1789652968/tele9782-dband-patch/02_Simulation_Results/Farfield_150_CST.png

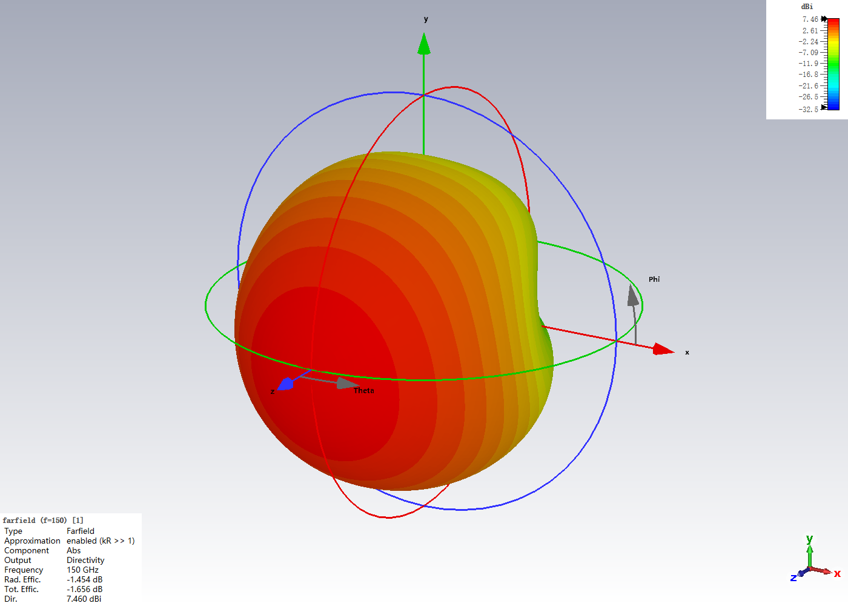
02_Simulation_Results/Farfield_150_CST.png
