1789652968/tele9782-dband-patch/01_CST_Project/farfield_146_summary.txt

Farfield Summary
---------------------
Array pattern: Single antenna
Monitor name: farfield (f=146) [1]
Plot mode: Directivity
Component: Abs
Plot type: 2D
Step angle Theta: 2
Step angle Phi  : 2
Coordinates: Spherical
Polarization: Abs
Frequency : 146 GHz
Radiation efficiency: -1.50464 dB 
Total efficiency: -2.62617 dB
Maximum directivity [dB]: 7.20686
Maximum gain [dB]: 5.70221
Maximum realized gain [dB]: 4.58069
