1789652968/tele9782-dband-patch/01_CST_Project/farfield_147_summary.txt

Farfield Summary
---------------------
Array pattern: Single antenna
Monitor name: farfield (f=147) [1]
Plot mode: Directivity
Component: Abs
Plot type: 2D
Step angle Theta: 2
Step angle Phi  : 2
Coordinates: Spherical
Polarization: Abs
Frequency : 147 GHz
Radiation efficiency: -1.44392 dB 
Total efficiency: -1.95549 dB
Maximum directivity [dB]: 7.28347
Maximum gain [dB]: 5.83955
Maximum realized gain [dB]: 5.32798
