1789652968/tele9782-dband-patch/01_CST_Project/farfield_149_summary.txt

Farfield Summary
---------------------
Array pattern: Single antenna
Monitor name: farfield (f=149) [1]
Plot mode: Directivity
Component: Abs
Plot type: 2D
Step angle Theta: 2
Step angle Phi  : 2
Coordinates: Spherical
Polarization: Abs
Frequency : 149 GHz
Radiation efficiency: -1.4239 dB 
Total efficiency: -1.42811 dB
Maximum directivity [dB]: 7.40966
Maximum gain [dB]: 5.98575
Maximum realized gain [dB]: 5.98155
