1789652968/tele9782-dband-patch/01_CST_Project/farfield_150_summary.txt

Farfield Summary
---------------------
Array pattern: Single antenna
Monitor name: farfield (f=150) [1]
Plot mode: Directivity
Component: Abs
Plot type: 2D
Step angle Theta: 2
Step angle Phi  : 2
Coordinates: Spherical
Polarization: Abs
Frequency : 150 GHz
Radiation efficiency: -1.45371 dB 
Total efficiency: -1.65573 dB
Maximum directivity [dB]: 7.46017
Maximum gain [dB]: 6.00646
Maximum realized gain [dB]: 5.80443
