1789652968/tele9782-dband-patch/01_CST_Project/farfield_152_summary.txt

Farfield Summary
---------------------
Array pattern: Single antenna
Monitor name: farfield (f=152) [1]
Plot mode: Directivity
Component: Abs
Plot type: 2D
Step angle Theta: 2
Step angle Phi  : 2
Coordinates: Spherical
Polarization: Abs
Frequency : 152 GHz
Radiation efficiency: -1.6087 dB 
Total efficiency: -2.87461 dB
Maximum directivity [dB]: 7.53211
Maximum gain [dB]: 5.92341
Maximum realized gain [dB]: 4.65751
