1789652968/tele9782-dband-patch/06_Working/Box_Coarse/farfield_130_summary.txt

Farfield Summary
---------------------
Array pattern: Single antenna
Monitor name: farfield (f=130) [1]
Plot mode: Directivity
Component: Abs
Plot type: 2D
Step angle Theta: 2
Step angle Phi  : 2
Coordinates: Spherical
Polarization: Abs
Frequency : 130 GHz
Radiation efficiency: -3.75192 dB 
Total efficiency: -12.4279 dB
Maximum directivity [dB]: 4.8401
Maximum gain [dB]: 1.08818
Maximum realized gain [dB]: -7.58782
