1789652968/tele9782-dband-patch/06_Working/Box_Coarse/farfield_140_summary.txt

Farfield Summary
---------------------
Array pattern: Single antenna
Monitor name: farfield (f=140) [1]
Plot mode: Directivity
Component: Abs
Plot type: 2D
Step angle Theta: 2
Step angle Phi  : 2
Coordinates: Spherical
Polarization: Abs
Frequency : 140 GHz
Radiation efficiency: -2.28199 dB 
Total efficiency: -7.97119 dB
Maximum directivity [dB]: 6.37631
Maximum gain [dB]: 4.09433
Maximum realized gain [dB]: -1.59488
