1789652968/tele9782-dband-patch/06_Working/Box_Coarse/farfield_148_summary.txt

Farfield Summary
---------------------
Array pattern: Single antenna
Monitor name: farfield (f=148) [1]
Plot mode: Directivity
Component: Abs
Plot type: 2D
Step angle Theta: 2
Step angle Phi  : 2
Coordinates: Spherical
Polarization: Abs
Frequency : 148 GHz
Radiation efficiency: -1.34051 dB 
Total efficiency: -1.76853 dB
Maximum directivity [dB]: 7.35717
Maximum gain [dB]: 6.01666
Maximum realized gain [dB]: 5.58864
