1789652968/tele9782-dband-patch/06_Working/Box_Coarse/farfield_149_summary.txt

Farfield Summary
---------------------
Array pattern: Single antenna
Monitor name: farfield (f=149) [1]
Plot mode: Directivity
Component: Abs
Plot type: 2D
Step angle Theta: 2
Step angle Phi  : 2
Coordinates: Spherical
Polarization: Abs
Frequency : 149 GHz
Radiation efficiency: -1.32675 dB 
Total efficiency: -1.39835 dB
Maximum directivity [dB]: 7.43263
Maximum gain [dB]: 6.10588
Maximum realized gain [dB]: 6.03429
