1789652968/tele9782-dband-patch/06_Working/Box_Coarse/farfield_150_summary.txt

Farfield Summary
---------------------
Array pattern: Single antenna
Monitor name: farfield (f=150) [1]
Plot mode: Directivity
Component: Abs
Plot type: 2D
Step angle Theta: 2
Step angle Phi  : 2
Coordinates: Spherical
Polarization: Abs
Frequency : 150 GHz
Radiation efficiency: -1.33562 dB 
Total efficiency: -1.35309 dB
Maximum directivity [dB]: 7.49745
Maximum gain [dB]: 6.16183
Maximum realized gain [dB]: 6.14435
