1789652968/tele9782-dband-patch/06_Working/Box_Coarse/farfield_151_summary.txt

Farfield Summary
---------------------
Array pattern: Single antenna
Monitor name: farfield (f=151) [1]
Plot mode: Directivity
Component: Abs
Plot type: 2D
Step angle Theta: 2
Step angle Phi  : 2
Coordinates: Spherical
Polarization: Abs
Frequency : 151 GHz
Radiation efficiency: -1.36631 dB 
Total efficiency: -1.63684 dB
Maximum directivity [dB]: 7.55461
Maximum gain [dB]: 6.1883
Maximum realized gain [dB]: 5.91777
