1789652968/tele9782-dband-patch/06_Working/Box_Coarse/farfield_153_summary.txt

Farfield Summary
---------------------
Array pattern: Single antenna
Monitor name: farfield (f=153) [1]
Plot mode: Directivity
Component: Abs
Plot type: 2D
Step angle Theta: 2
Step angle Phi  : 2
Coordinates: Spherical
Polarization: Abs
Frequency : 153 GHz
Radiation efficiency: -1.51605 dB 
Total efficiency: -2.92833 dB
Maximum directivity [dB]: 7.63794
Maximum gain [dB]: 6.12189
Maximum realized gain [dB]: 4.70961
