1789652968/tele9782-dband-patch/06_Working/Box_Coarse/farfield_154_summary.txt

Farfield Summary
---------------------
Array pattern: Single antenna
Monitor name: farfield (f=154) [1]
Plot mode: Directivity
Component: Abs
Plot type: 2D
Step angle Theta: 2
Step angle Phi  : 2
Coordinates: Spherical
Polarization: Abs
Frequency : 154 GHz
Radiation efficiency: -1.62988 dB 
Total efficiency: -3.73695 dB
Maximum directivity [dB]: 7.66373
Maximum gain [dB]: 6.03386
Maximum realized gain [dB]: 3.92678
