1789652968/tele9782-dband-patch/06_Working/Box_Coarse/farfield_160_summary.txt

Farfield Summary
---------------------
Array pattern: Single antenna
Monitor name: farfield (f=160) [1]
Plot mode: Directivity
Component: Abs
Plot type: 2D
Step angle Theta: 2
Step angle Phi  : 2
Coordinates: Spherical
Polarization: Abs
Frequency : 160 GHz
Radiation efficiency: -2.5683 dB 
Total efficiency: -8.09701 dB
Maximum directivity [dB]: 7.62737
Maximum gain [dB]: 5.05907
Maximum realized gain [dB]: -0.469641
