1789652968/tele9782-dband-patch/06_Working/Box_Coarse/farfield_170_summary.txt

Farfield Summary
---------------------
Array pattern: Single antenna
Monitor name: farfield (f=170) [1]
Plot mode: Directivity
Component: Abs
Plot type: 2D
Step angle Theta: 2
Step angle Phi  : 2
Coordinates: Spherical
Polarization: Abs
Frequency : 170 GHz
Radiation efficiency: -4.07395 dB 
Total efficiency: -11.7199 dB
Maximum directivity [dB]: 7.00213
Maximum gain [dB]: 2.92817
Maximum realized gain [dB]: -4.71778
