1789652968/tele9782-dband-patch/06_Working/Box_Fine/farfield_170_summary.txt

Farfield Summary
---------------------
Array pattern: Single antenna
Monitor name: farfield (f=170) [1]
Plot mode: Directivity
Component: Abs
Plot type: 2D
Step angle Theta: 2
Step angle Phi  : 2
Coordinates: Spherical
Polarization: Abs
Frequency : 170 GHz
Radiation efficiency: -4.36843 dB 
Total efficiency: -11.6953 dB
Maximum directivity [dB]: 6.99306
Maximum gain [dB]: 2.62463
Maximum realized gain [dB]: -4.70224
