1789652968/tele9782-dband-patch/06_Working/Inset_0.13/farfield_170_summary.txt

Farfield Summary
---------------------
Array pattern: Single antenna
Monitor name: farfield (f=170) [1]
Plot mode: Directivity
Component: Abs
Plot type: 2D
Step angle Theta: 2
Step angle Phi  : 2
Coordinates: Spherical
Polarization: Abs
Frequency : 170 GHz
Radiation efficiency: -3.3543 dB 
Total efficiency: -10.0292 dB
Maximum directivity [dB]: 7.95644
Maximum gain [dB]: 4.60214
Maximum realized gain [dB]: -2.07281
