1789652968/tele9782-dband-patch/06_Working/Inset_0.17/farfield_150_summary.txt

Farfield Summary
---------------------
Array pattern: Single antenna
Monitor name: farfield (f=150) [1]
Plot mode: Directivity
Component: Abs
Plot type: 2D
Step angle Theta: 2
Step angle Phi  : 2
Coordinates: Spherical
Polarization: Abs
Frequency : 150 GHz
Radiation efficiency: -1.55183 dB 
Total efficiency: -2.03358 dB
Maximum directivity [dB]: 7.71211
Maximum gain [dB]: 6.16028
Maximum realized gain [dB]: 5.67853
