1789652968/tele9782-dband-patch/06_Working/Inset_0.17/farfield_160_summary.txt

Farfield Summary
---------------------
Array pattern: Single antenna
Monitor name: farfield (f=160) [1]
Plot mode: Directivity
Component: Abs
Plot type: 2D
Step angle Theta: 2
Step angle Phi  : 2
Coordinates: Spherical
Polarization: Abs
Frequency : 160 GHz
Radiation efficiency: -2.66862 dB 
Total efficiency: -7.95058 dB
Maximum directivity [dB]: 7.91719
Maximum gain [dB]: 5.24857
Maximum realized gain [dB]: -0.0333876
