1789652968/tele9782-dband-patch/06_Working/Inset_0.19/farfield_130_summary.txt

Farfield Summary
---------------------
Array pattern: Single antenna
Monitor name: farfield (f=130) [1]
Plot mode: Directivity
Component: Abs
Plot type: 2D
Step angle Theta: 2
Step angle Phi  : 2
Coordinates: Spherical
Polarization: Abs
Frequency : 130 GHz
Radiation efficiency: -3.77351 dB 
Total efficiency: -12.2152 dB
Maximum directivity [dB]: 5.5448
Maximum gain [dB]: 1.77129
Maximum realized gain [dB]: -6.67037
