1789652968/tele9782-dband-patch/06_Working/Inset_0.19/farfield_140_summary.txt

Farfield Summary
---------------------
Array pattern: Single antenna
Monitor name: farfield (f=140) [1]
Plot mode: Directivity
Component: Abs
Plot type: 2D
Step angle Theta: 2
Step angle Phi  : 2
Coordinates: Spherical
Polarization: Abs
Frequency : 140 GHz
Radiation efficiency: -2.14669 dB 
Total efficiency: -6.7448 dB
Maximum directivity [dB]: 6.82934
Maximum gain [dB]: 4.68265
Maximum realized gain [dB]: 0.0845459
