1789652968/tele9782-dband-patch/06_Working/Inset_0.19/farfield_170_summary.txt

Farfield Summary
---------------------
Array pattern: Single antenna
Monitor name: farfield (f=170) [1]
Plot mode: Directivity
Component: Abs
Plot type: 2D
Step angle Theta: 2
Step angle Phi  : 2
Coordinates: Spherical
Polarization: Abs
Frequency : 170 GHz
Radiation efficiency: -4.38659 dB 
Total efficiency: -12.2489 dB
Maximum directivity [dB]: 7.15376
Maximum gain [dB]: 2.76717
Maximum realized gain [dB]: -5.09515
