1789652968/tele9782-dband-patch/06_Working/Single_Baseline/farfield_140_summary.txt

Farfield Summary
---------------------
Array pattern: Single antenna
Monitor name: farfield (f=140) [1]
Plot mode: Directivity
Component: Abs
Plot type: 2D
Step angle Theta: 2
Step angle Phi  : 2
Coordinates: Spherical
Polarization: Abs
Frequency : 140 GHz
Radiation efficiency: -2.01016 dB 
Total efficiency: -5.92421 dB
Maximum directivity [dB]: 6.83598
Maximum gain [dB]: 4.82582
Maximum realized gain [dB]: 0.911762
