1789652968/tele9782-dband-patch/06_Working/Single_Baseline/farfield_160_summary.txt

Farfield Summary
---------------------
Array pattern: Single antenna
Monitor name: farfield (f=160) [1]
Plot mode: Directivity
Component: Abs
Plot type: 2D
Step angle Theta: 2
Step angle Phi  : 2
Coordinates: Spherical
Polarization: Abs
Frequency : 160 GHz
Radiation efficiency: -2.36854 dB 
Total efficiency: -7.09138 dB
Maximum directivity [dB]: 8.05388
Maximum gain [dB]: 5.68534
Maximum realized gain [dB]: 0.962498
