1789652968/tele9782-dband-patch/06_Working/Single_Baseline/farfield_170_summary.txt

Farfield Summary
---------------------
Array pattern: Single antenna
Monitor name: farfield (f=170) [1]
Plot mode: Directivity
Component: Abs
Plot type: 2D
Step angle Theta: 2
Step angle Phi  : 2
Coordinates: Spherical
Polarization: Abs
Frequency : 170 GHz
Radiation efficiency: -3.47748 dB 
Total efficiency: -10.413 dB
Maximum directivity [dB]: 7.67602
Maximum gain [dB]: 4.19855
Maximum realized gain [dB]: -2.73693
