1789652968/tele9782-dband-patch/06_Working/Tuned_Coarse/farfield_130_summary.txt

Farfield Summary
---------------------
Array pattern: Single antenna
Monitor name: farfield (f=130) [1]
Plot mode: Directivity
Component: Abs
Plot type: 2D
Step angle Theta: 2
Step angle Phi  : 2
Coordinates: Spherical
Polarization: Abs
Frequency : 130 GHz
Radiation efficiency: -4.54714 dB 
Total efficiency: -13.0068 dB
Maximum directivity [dB]: 5.45446
Maximum gain [dB]: 0.907329
Maximum realized gain [dB]: -7.55233
