1789652968/tele9782-dband-patch/06_Working/Tuned_Coarse/farfield_140_summary.txt

Farfield Summary
---------------------
Array pattern: Single antenna
Monitor name: farfield (f=140) [1]
Plot mode: Directivity
Component: Abs
Plot type: 2D
Step angle Theta: 2
Step angle Phi  : 2
Coordinates: Spherical
Polarization: Abs
Frequency : 140 GHz
Radiation efficiency: -2.57054 dB 
Total efficiency: -8.26781 dB
Maximum directivity [dB]: 6.65858
Maximum gain [dB]: 4.08804
Maximum realized gain [dB]: -1.60923
