1789652968/tele9782-dband-patch/06_Working/Tuned_Coarse/farfield_149_summary.txt

Farfield Summary
---------------------
Array pattern: Single antenna
Monitor name: farfield (f=149) [1]
Plot mode: Directivity
Component: Abs
Plot type: 2D
Step angle Theta: 2
Step angle Phi  : 2
Coordinates: Spherical
Polarization: Abs
Frequency : 149 GHz
Radiation efficiency: -1.48893 dB 
Total efficiency: -1.5596 dB
Maximum directivity [dB]: 7.55315
Maximum gain [dB]: 6.06422
Maximum realized gain [dB]: 5.99354
