1789652968/tele9782-dband-patch/06_Working/Tuned_Coarse/farfield_151_summary.txt

Farfield Summary
---------------------
Array pattern: Single antenna
Monitor name: farfield (f=151) [1]
Plot mode: Directivity
Component: Abs
Plot type: 2D
Step angle Theta: 2
Step angle Phi  : 2
Coordinates: Spherical
Polarization: Abs
Frequency : 151 GHz
Radiation efficiency: -1.5219 dB 
Total efficiency: -1.78983 dB
Maximum directivity [dB]: 7.66224
Maximum gain [dB]: 6.14034
Maximum realized gain [dB]: 5.87241
