1789652968/tele9782-dband-patch/06_Working/Tuned_Coarse/farfield_160_summary.txt

Farfield Summary
---------------------
Array pattern: Single antenna
Monitor name: farfield (f=160) [1]
Plot mode: Directivity
Component: Abs
Plot type: 2D
Step angle Theta: 2
Step angle Phi  : 2
Coordinates: Spherical
Polarization: Abs
Frequency : 160 GHz
Radiation efficiency: -2.79227 dB 
Total efficiency: -8.28865 dB
Maximum directivity [dB]: 7.70668
Maximum gain [dB]: 4.91441
Maximum realized gain [dB]: -0.581968
