1789652968/tele9782-dband-patch/06_Working/Tuned_Coarse/farfield_170_summary.txt

Farfield Summary
---------------------
Array pattern: Single antenna
Monitor name: farfield (f=170) [1]
Plot mode: Directivity
Component: Abs
Plot type: 2D
Step angle Theta: 2
Step angle Phi  : 2
Coordinates: Spherical
Polarization: Abs
Frequency : 170 GHz
Radiation efficiency: -4.39915 dB 
Total efficiency: -11.8724 dB
Maximum directivity [dB]: 7.15462
Maximum gain [dB]: 2.75546
Maximum realized gain [dB]: -4.71779
