1789652968/tele9782-dband-patch/06_Working/Tuned_Fine/farfield_148_summary.txt

Farfield Summary
---------------------
Array pattern: Single antenna
Monitor name: farfield (f=148) [1]
Plot mode: Directivity
Component: Abs
Plot type: 2D
Step angle Theta: 2
Step angle Phi  : 2
Coordinates: Spherical
Polarization: Abs
Frequency : 148 GHz
Radiation efficiency: -2.46228 dB 
Total efficiency: -2.56843 dB
Maximum directivity [dB]: 8.44354
Maximum gain [dB]: 5.98126
Maximum realized gain [dB]: 5.87511
