1789652968/tele9782-dband-patch/06_Working/Tuned_Fine/farfield_149_summary.txt

Farfield Summary
---------------------
Array pattern: Single antenna
Monitor name: farfield (f=149) [1]
Plot mode: Directivity
Component: Abs
Plot type: 2D
Step angle Theta: 2
Step angle Phi  : 2
Coordinates: Spherical
Polarization: Abs
Frequency : 149 GHz
Radiation efficiency: -2.45917 dB 
Total efficiency: -2.46527 dB
Maximum directivity [dB]: 8.48577
Maximum gain [dB]: 6.02661
Maximum realized gain [dB]: 6.0205
