1789652968/tele9782-dband-patch/06_Working/Tuned_Fine/farfield_150_summary.txt

Farfield Summary
---------------------
Array pattern: Single antenna
Monitor name: farfield (f=150) [1]
Plot mode: Directivity
Component: Abs
Plot type: 2D
Step angle Theta: 2
Step angle Phi  : 2
Coordinates: Spherical
Polarization: Abs
Frequency : 150 GHz
Radiation efficiency: -2.49148 dB 
Total efficiency: -2.7048 dB
Maximum directivity [dB]: 8.53586
Maximum gain [dB]: 6.04438
Maximum realized gain [dB]: 5.83106
