1789652968/tele9782-dband-patch/06_Working/Tuned_Fine/farfield_151_summary.txt

Farfield Summary
---------------------
Array pattern: Single antenna
Monitor name: farfield (f=151) [1]
Plot mode: Directivity
Component: Abs
Plot type: 2D
Step angle Theta: 2
Step angle Phi  : 2
Coordinates: Spherical
Polarization: Abs
Frequency : 151 GHz
Radiation efficiency: -2.57119 dB 
Total efficiency: -3.25059 dB
Maximum directivity [dB]: 8.60046
Maximum gain [dB]: 6.02927
Maximum realized gain [dB]: 5.34987
