1789652968/tele9782-dband-patch/06_Working/Tuned_Fine/farfield_152_summary.txt

Farfield Summary
---------------------
Array pattern: Single antenna
Monitor name: farfield (f=152) [1]
Plot mode: Directivity
Component: Abs
Plot type: 2D
Step angle Theta: 2
Step angle Phi  : 2
Coordinates: Spherical
Polarization: Abs
Frequency : 152 GHz
Radiation efficiency: -2.7162 dB 
Total efficiency: -4.02516 dB
Maximum directivity [dB]: 8.68089
Maximum gain [dB]: 5.96468
Maximum realized gain [dB]: 4.65572
