1789652968/tele9782-dband-patch/06_Working/Tuned_Fine/farfield_153_summary.txt

Farfield Summary
---------------------
Array pattern: Single antenna
Monitor name: farfield (f=153) [1]
Plot mode: Directivity
Component: Abs
Plot type: 2D
Step angle Theta: 2
Step angle Phi  : 2
Coordinates: Spherical
Polarization: Abs
Frequency : 153 GHz
Radiation efficiency: -2.92924 dB 
Total efficiency: -4.92439 dB
Maximum directivity [dB]: 8.77967
Maximum gain [dB]: 5.85043
Maximum realized gain [dB]: 3.85528
