1789652968/tele9782-dband-patch/06_Working/Tuned_Fine/farfield_154_summary.txt

Farfield Summary
---------------------
Array pattern: Single antenna
Monitor name: farfield (f=154) [1]
Plot mode: Directivity
Component: Abs
Plot type: 2D
Step angle Theta: 2
Step angle Phi  : 2
Coordinates: Spherical
Polarization: Abs
Frequency : 154 GHz
Radiation efficiency: -3.18498 dB 
Total efficiency: -5.85343 dB
Maximum directivity [dB]: 8.8961
Maximum gain [dB]: 5.71112
Maximum realized gain [dB]: 3.04267
