1789652968/tele9782-dband-patch/06_Working/Tuned_Fine/farfield_160_summary.txt

Farfield Summary
---------------------
Array pattern: Single antenna
Monitor name: farfield (f=160) [1]
Plot mode: Directivity
Component: Abs
Plot type: 2D
Step angle Theta: 2
Step angle Phi  : 2
Coordinates: Spherical
Polarization: Abs
Frequency : 160 GHz
Radiation efficiency: -5.35279 dB 
Total efficiency: -11.0575 dB
Maximum directivity [dB]: 9.89964
Maximum gain [dB]: 4.54685
Maximum realized gain [dB]: -1.15784
