1789652968/tele9782-dband-patch/06_Working/Tuned_Fine/farfield_170_summary.txt

Farfield Summary
---------------------
Array pattern: Single antenna
Monitor name: farfield (f=170) [1]
Plot mode: Directivity
Component: Abs
Plot type: 2D
Step angle Theta: 2
Step angle Phi  : 2
Coordinates: Spherical
Polarization: Abs
Frequency : 170 GHz
Radiation efficiency: -9.24153 dB 
Total efficiency: -16.692 dB
Maximum directivity [dB]: 11.9697
Maximum gain [dB]: 2.72816
Maximum realized gain [dB]: -4.72234
