1789652968/tele9782-dband-patch/06_Presentation/TELE9782_Speaker_Cue_Cards.docx

# TELE9782 Speaker Cue Cards

Keep slide order. Practise without reading the script.

## 01 00:00–00:30 | Design and Simulation of a D-Band Microstrip Patch Antenna

Introduce both presenters. Objective is >6.5 dBi in 130–170 GHz. Preview theory → model → evidence.

## 02 00:30–01:20 | Project requirements

150 GHz near midpoint. Name all five outputs. Separate sweep from matched bandwidth.

## 03 01:20–02:30 | Rectangular patch theory

TM₁₀ half wave along L. Two edges add broadside. εeff accounts for air and substrate. Subtract two fringes.

## 04 02:30–03:45 | Analytical design and final parameters

Start 0.666 × 0.520 mm. Final 0.667 × 0.513 mm. 152.000 estimate vs 148.840 match dip. Nominal materials.

## 05 03:45–05:00 | CST model and simulation setup

Point to launch and port. +y quasi-TEM, 50 Ω reference. Open boundaries, lossy HF Time Domain, 13 monitors. Hand over to Ning.

# Ning Mao · 05:00–10:00

## 06 05:00–06:10 | Troubleshooting and optimisation

Invalid −20.92 → repair port/launch → inset sweep → shorten L → enclosing farfield and numerical checks.

## 07 06:10–07:15 | Resonance and S₁₁

Point to 150 marker, match dip and −10 line. −13.424 dB at 150. 147.106 to 150.619 GHz gives 3.513 GHz / 2.36%.

## 08 07:15–08:25 | Directivity and realized gain

Point to both plots. 7.460 dBi and +0.960 dB margin. 5.804 dBi realized gain accounts for losses and mismatch.

## 09 08:25–09:30 | Efficiency and radiation patterns

71.55% ηrad. E yz, H xz from y polarisation. Forward main lobe near +z and θ≈4°.

## 10 09:30–10:00 | Validation and conclusion

0.037 dB mesh difference, 0.9991 sphere, 0.754% residual. Reopened and reran. Thank and invite questions.

Backup routing · 11 calculation / 12 parameters / 13 port / 14 checks / 15 frequency table / 16 beam / 17 diagnostic history.
