1789652968/tele9782-dband-patch/03_Figures/Parameter_List.png

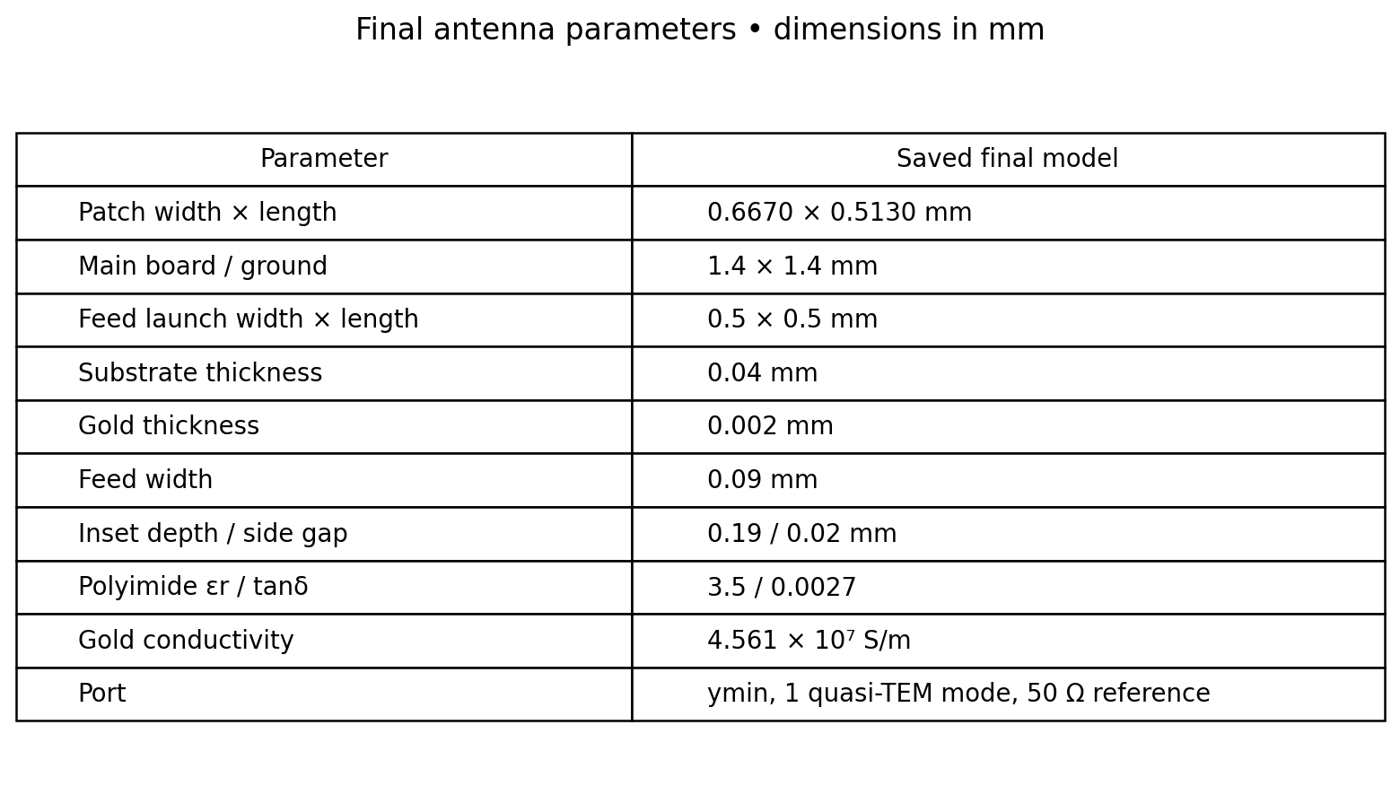
03_Figures/Parameter_List.png
