1789652968/tele9782-dband-patch/(list of files, cad)

Other CAD files:
01_CST_Project/TELE9782_DBand_Patch_Final/ModelCache/Model.psm
01_CST_Project/TELE9782_DBand_Patch_Final/Result/Port1_e1.prt
01_CST_Project/TELE9782_DBand_Patch_Final/Result/Port1_e1[150].prt
01_CST_Project/TELE9782_DBand_Patch_Final/Result/Port1_h1.prt
01_CST_Project/TELE9782_DBand_Patch_Final/Result/Port1_h1[150].prt
01_CST_Project/TELE9782_DBand_Patch_Final/Result/adapt_Port1_e1.prt
01_CST_Project/TELE9782_DBand_Patch_Final/Result/adapt_Port1_e1[150].prt
01_CST_Project/TELE9782_DBand_Patch_Final/Result/adapt_Port1_h1.prt
01_CST_Project/TELE9782_DBand_Patch_Final/Result/adapt_Port1_h1[150].prt
06_Working/Box_Coarse/Box_Coarse/ModelCache/Model.psm
06_Working/Box_Coarse/Box_Coarse/Result/Port1_e1.prt
06_Working/Box_Coarse/Box_Coarse/Result/Port1_e1[150].prt
06_Working/Box_Coarse/Box_Coarse/Result/Port1_h1.prt
06_Working/Box_Coarse/Box_Coarse/Result/Port1_h1[150].prt
06_Working/Box_Coarse/Box_Coarse/Result/adapt_Port1_e1.prt
06_Working/Box_Coarse/Box_Coarse/Result/adapt_Port1_e1[150].prt
06_Working/Box_Coarse/Box_Coarse/Result/adapt_Port1_h1.prt
06_Working/Box_Coarse/Box_Coarse/Result/adapt_Port1_h1[150].prt
06_Working/Box_Fine/Box_Fine/ModelCache/Model.psm
06_Working/Box_Fine/Box_Fine/Result/Port1_e1.prt
06_Working/Box_Fine/Box_Fine/Result/Port1_e1[150].prt
06_Working/Box_Fine/Box_Fine/Result/Port1_h1.prt
06_Working/Box_Fine/Box_Fine/Result/Port1_h1[150].prt
06_Working/Box_Fine/Box_Fine/Result/adapt_Port1_e1.prt
06_Working/Box_Fine/Box_Fine/Result/adapt_Port1_e1[150].prt
06_Working/Box_Fine/Box_Fine/Result/adapt_Port1_h1.prt
06_Working/Box_Fine/Box_Fine/Result/adapt_Port1_h1[150].prt
06_Working/Inset_0.13/Inset_0.13/ModelCache/Model.psm
06_Working/Inset_0.13/Inset_0.13/Result/Port1_e1.prt
06_Working/Inset_0.13/Inset_0.13/Result/Port1_e1[150].prt
06_Working/Inset_0.13/Inset_0.13/Result/Port1_h1.prt
06_Working/Inset_0.13/Inset_0.13/Result/Port1_h1[150].prt
06_Working/Inset_0.13/Inset_0.13/Result/adapt_Port1_e1.prt
06_Working/Inset_0.13/Inset_0.13/Result/adapt_Port1_e1[150].prt
06_Working/Inset_0.13/Inset_0.13/Result/adapt_Port1_h1.prt
06_Working/Inset_0.13/Inset_0.13/Result/adapt_Port1_h1[150].prt
06_Working/Inset_0.17/Inset_0.17/ModelCache/Model.psm
06_Working/Inset_0.17/Inset_0.17/Result/Port1_e1.prt
06_Working/Inset_0.17/Inset_0.17/Result/Port1_e1[150].prt
06_Working/Inset_0.17/Inset_0.17/Result/Port1_h1.prt
06_Working/Inset_0.17/Inset_0.17/Result/Port1_h1[150].prt
06_Working/Inset_0.17/Inset_0.17/Result/adapt_Port1_e1.prt
06_Working/Inset_0.17/Inset_0.17/Result/adapt_Port1_e1[150].prt
06_Working/Inset_0.17/Inset_0.17/Result/adapt_Port1_h1.prt
06_Working/Inset_0.17/Inset_0.17/Result/adapt_Port1_h1[150].prt
06_Working/Inset_0.19/Inset_0.19/ModelCache/Model.psm
06_Working/Inset_0.19/Inset_0.19/Result/Port1_e1.prt
06_Working/Inset_0.19/Inset_0.19/Result/Port1_e1[150].prt
06_Working/Inset_0.19/Inset_0.19/Result/Port1_h1.prt
06_Working/Inset_0.19/Inset_0.19/Result/Port1_h1[150].prt
06_Working/Inset_0.19/Inset_0.19/Result/adapt_Port1_e1.prt
06_Working/Inset_0.19/Inset_0.19/Result/adapt_Port1_e1[150].prt
06_Working/Inset_0.19/Inset_0.19/Result/adapt_Port1_h1.prt
06_Working/Inset_0.19/Inset_0.19/Result/adapt_Port1_h1[150].prt
06_Working/Original_Baseline/lab_projevt/ModelCache/Model.psm
06_Working/Original_Baseline/lab_projevt/Result/Port1_e1.prt
06_Working/Original_Baseline/lab_projevt/Result/Port1_e1[150].prt
06_Working/Original_Baseline/lab_projevt/Result/Port1_h1.prt
06_Working/Original_Baseline/lab_projevt/Result/Port1_h1[150].prt
06_Working/Original_Baseline/lab_projevt/Result/adapt_Port1_e1.prt
06_Working/Original_Baseline/lab_projevt/Result/adapt_Port1_e1[150].prt
06_Working/Original_Baseline/lab_projevt/Result/adapt_Port1_h1.prt
06_Working/Original_Baseline/lab_projevt/Result/adapt_Port1_h1[150].prt
06_Working/Port_Corrected/ModelCache/Model.psm
06_Working/Port_Corrected/Result/Port1_e1.prt
06_Working/Port_Corrected/Result/Port1_e1[150].prt
06_Working/Port_Corrected/Result/Port1_h1.prt
06_Working/Port_Corrected/Result/Port1_h1[150].prt
06_Working/Port_Corrected/Result/adapt_Port1_e1.prt
06_Working/Port_Corrected/Result/adapt_Port1_e1[150].prt
06_Working/Port_Corrected/Result/adapt_Port1_h1.prt
06_Working/Port_Corrected/Result/adapt_Port1_h1[150].prt
06_Working/Single_Baseline/Single_Baseline/ModelCache/Model.psm
06_Working/Single_Baseline/Single_Baseline/Result/Port1_e1.prt
06_Working/Single_Baseline/Single_Baseline/Result/Port1_e1[150].prt
06_Working/Single_Baseline/Single_Baseline/Result/Port1_h1.prt
06_Working/Single_Baseline/Single_Baseline/Result/Port1_h1[150].prt
06_Working/Single_Baseline/Single_Baseline/Result/adapt_Port1_e1.prt
06_Working/Single_Baseline/Single_Baseline/Result/adapt_Port1_e1[150].prt
06_Working/Single_Baseline/Single_Baseline/Result/adapt_Port1_h1.prt
06_Working/Single_Baseline/Single_Baseline/Result/adapt_Port1_h1[150].prt
06_Working/Tuned_Coarse/Tuned_Coarse/ModelCache/Model.psm
06_Working/Tuned_Coarse/Tuned_Coarse/Result/Port1_e1.prt
06_Working/Tuned_Coarse/Tuned_Coarse/Result/Port1_e1[150].prt
06_Working/Tuned_Coarse/Tuned_Coarse/Result/Port1_h1.prt
06_Working/Tuned_Coarse/Tuned_Coarse/Result/Port1_h1[150].prt
06_Working/Tuned_Coarse/Tuned_Coarse/Result/adapt_Port1_e1.prt
06_Working/Tuned_Coarse/Tuned_Coarse/Result/adapt_Port1_e1[150].prt
06_Working/Tuned_Coarse/Tuned_Coarse/Result/adapt_Port1_h1.prt
06_Working/Tuned_Coarse/Tuned_Coarse/Result/adapt_Port1_h1[150].prt
06_Working/Tuned_Fine/Tuned_Fine/ModelCache/Model.psm
06_Working/Tuned_Fine/Tuned_Fine/Result/Port1_e1.prt
06_Working/Tuned_Fine/Tuned_Fine/Result/Port1_e1[150].prt
06_Working/Tuned_Fine/Tuned_Fine/Result/Port1_h1.prt
06_Working/Tuned_Fine/Tuned_Fine/Result/Port1_h1[150].prt
06_Working/Tuned_Fine/Tuned_Fine/Result/adapt_Port1_e1.prt
06_Working/Tuned_Fine/Tuned_Fine/Result/adapt_Port1_e1[150].prt
06_Working/Tuned_Fine/Tuned_Fine/Result/adapt_Port1_h1.prt
06_Working/Tuned_Fine/Tuned_Fine/Result/adapt_Port1_h1[150].prt
06_Working/Tuned_Finer/Tuned_Finer/ModelCache/Model.psm
06_Working/Tuned_Finer/Tuned_Finer/Result/Port1_e1.prt
06_Working/Tuned_Finer/Tuned_Finer/Result/Port1_e1[150].prt
06_Working/Tuned_Finer/Tuned_Finer/Result/Port1_h1.prt
06_Working/Tuned_Finer/Tuned_Finer/Result/Port1_h1[150].prt
06_Working/Tuned_Finer/Tuned_Finer/Result/adapt_Port1_e1.prt
06_Working/Tuned_Finer/Tuned_Finer/Result/adapt_Port1_e1[150].prt
06_Working/Tuned_Finer/Tuned_Finer/Result/adapt_Port1_h1.prt
06_Working/Tuned_Finer/Tuned_Finer/Result/adapt_Port1_h1[150].prt
07_Original_Patch/lab_projevt/ModelCache/Model.psm
07_Original_Patch/lab_projevt/Result/Port1_e1.prt
07_Original_Patch/lab_projevt/Result/Port1_e1[150].prt
07_Original_Patch/lab_projevt/Result/Port1_h1.prt
07_Original_Patch/lab_projevt/Result/Port1_h1[150].prt
07_Original_Patch/lab_projevt/Result/adapt_Port1_e1.prt
07_Original_Patch/lab_projevt/Result/adapt_Port1_e1[150].prt
07_Original_Patch/lab_projevt/Result/adapt_Port1_h1.prt
07_Original_Patch/lab_projevt/Result/adapt_Port1_h1[150].prt
