1789652968/tele9782-dband-patch/01_CST_Project/1D Results_Balance_Balance [1].csv

x | real | imag
130.0 | 0.9218198888880935 | 0.0
130.0399932861328 | 0.9216389868886015 | 0.0
130.0800018310547 | 0.9214543656712908 | 0.0
130.1199951171875 | 0.9212661240961157 | 0.0
130.16000366210938 | 0.9210749757934946 | 0.0
130.1999969482422 | 0.9208806834678045 | 0.0
130.24000549316406 | 0.9206840117798951 | 0.0
130.27999877929688 | 0.9204849723937989 | 0.0
130.32000732421875 | 0.9202840158666072 | 0.0
130.36000061035156 | 0.9200814632335798 | 0.0
130.39999389648438 | 0.9198774632446161 | 0.0
130.44000244140625 | 0.9196723768433696 | 0.0
130.47999572753906 | 0.919466670879356 | 0.0
130.52000427246094 | 0.9192603557765127 | 0.0
130.55999755859375 | 0.9190539788159555 | 0.0
130.60000610351562 | 0.9188476732293982 | 0.0
130.63999938964844 | 0.918641746322232 | 0.0
130.67999267578125 | 0.9184363748703641 | 0.0
130.72000122070312 | 0.9182321460183308 | 0.0
130.75999450683594 | 0.9180289136133847 | 0.0
130.8000030517578 | 0.917827101060644 | 0.0
130.83999633789062 | 0.9176269251346056 | 0.0
130.8800048828125 | 0.9174285681619155 | 0.0
130.9199981689453 | 0.9172321802759282 | 0.0
130.9600067138672 | 0.9170380135549018 | 0.0
131.0 | 0.9168462752925131 | 0.0
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
