1789652968/tele9782-dband-patch/01_CST_Project/1D Results_Efficiencies_Rad. Efficiency [1].csv

x | real | imag
130.0 | 0.36695190416222034 | 0.0
140.0 | 0.573641606574304 | 0.0
146.0 | 0.70718943866781 | 0.0
147.0 | 0.717147322216038 | 0.0
148.0 | 0.7211653054564152 | 0.0
149.0 | 0.7204594870711845 | 0.0
150.0 | 0.7155315084418604 | 0.0
151.0 | 0.7056757733013279 | 0.0
152.0 | 0.6904463240868698 | 0.0
153.0 | 0.6713071965611479 | 0.0
154.0 | 0.6506068225933629 | 0.0
160.0 | 0.5103117518644169 | 0.0
170.0 | 0.36573879066313686 | 0.0
