1789652968/tele9782-dband-patch/01_CST_Project/1D Results_Efficiencies_Tot. Efficiency [1].csv

x | real | imag
130.0 | 0.05513384739572226 | 0.0
140.0 | 0.175095429083318 | 0.0
146.0 | 0.5462395920342722 | 0.0
147.0 | 0.6374574043635182 | 0.0
148.0 | 0.7026639295194778 | 0.0
149.0 | 0.719762838679122 | 0.0
150.0 | 0.6830092904525017 | 0.0
151.0 | 0.6069158252213458 | 0.0
152.0 | 0.515868826789994 | 0.0
153.0 | 0.42952284645933925 | 0.0
154.0 | 0.35622449574709164 | 0.0
160.0 | 0.1389660920064932 | 0.0
170.0 | 0.06768174567071812 | 0.0
