1789652968/tele9782-dband-patch/01_CST_Project/1D Results_Port Information_Line Impedance_1(1).csv

x | real | imag
150.0 | 49.468643576546214 | 0.0
