1789652968/tele9782-dband-patch/01_CST_Project/1D Results_Power_Excitation [1]_Loss in Dielectrics.csv

x | real | imag
130.0 | 0.01607130836581556 | 0.0
140.0 | 0.022030550614653283 | 0.0
150.0 | 0.04263566343383787 | 0.0
160.0 | 0.020744990871522553 | 0.0
170.0 | 0.017808756877230637 | 0.0
