1789652968/tele9782-dband-patch/01_CST_Project/1D Results_Power_Excitation [1]_Loss in Metals.csv

x | real | imag
130.0 | 0.030620948359714375 | 0.0
140.0 | 0.04107517219527354 | 0.0
150.0 | 0.08953741922113943 | 0.0
160.0 | 0.04432543833813384 | 0.0
170.0 | 0.0401260506610713 | 0.0
