1789652968/tele9782-dband-patch/(list of files, drawings)

Other design files:
01_CST_Project/TELE9782_DBand_Patch_Final/Model/3D/Model.dsn
01_CST_Project/TELE9782_DBand_Patch_Final/Model/DS/Model.dsn
06_Working/Box_Coarse/Box_Coarse/Model/3D/Model.dsn
06_Working/Box_Coarse/Box_Coarse/Model/DS/Model.dsn
06_Working/Box_Fine/Box_Fine/Model/3D/Model.dsn
06_Working/Box_Fine/Box_Fine/Model/DS/Model.dsn
06_Working/Inset_0.13/Inset_0.13/Model/3D/Model.dsn
06_Working/Inset_0.13/Inset_0.13/Model/DS/Model.dsn
06_Working/Inset_0.17/Inset_0.17/Model/3D/Model.dsn
06_Working/Inset_0.17/Inset_0.17/Model/DS/Model.dsn
06_Working/Inset_0.19/Inset_0.19/Model/3D/Model.dsn
06_Working/Inset_0.19/Inset_0.19/Model/DS/Model.dsn
06_Working/Original_Baseline/lab2222/Model/3D/Model.dsn
06_Working/Original_Baseline/lab2222/Model/DS/Model.dsn
06_Working/Original_Baseline/lab_projevt/Model/3D/Model.dsn
06_Working/Original_Baseline/lab_projevt/Model/DS/Model.dsn
06_Working/Port_Corrected/Model/3D/Model.dsn
06_Working/Port_Corrected/Model/DS/Model.dsn
06_Working/Single_Baseline/Single_Baseline/Model/3D/Model.dsn
06_Working/Single_Baseline/Single_Baseline/Model/DS/Model.dsn
06_Working/Tuned_Coarse/Tuned_Coarse/Model/3D/Model.dsn
06_Working/Tuned_Coarse/Tuned_Coarse/Model/DS/Model.dsn
06_Working/Tuned_Fine/Tuned_Fine/Model/3D/Model.dsn
06_Working/Tuned_Fine/Tuned_Fine/Model/DS/Model.dsn
06_Working/Tuned_Finer/Tuned_Finer/Model/3D/Model.dsn
06_Working/Tuned_Finer/Tuned_Finer/Model/DS/Model.dsn
07_Original_Patch/lab_projevt/Model/3D/Model.dsn
07_Original_Patch/lab_projevt/Model/DS/Model.dsn
